abdalla2427/leitura-tc/Documentação/RelatorioParcial/imagens/esquema_ambiente_de_testes_2.jpeg

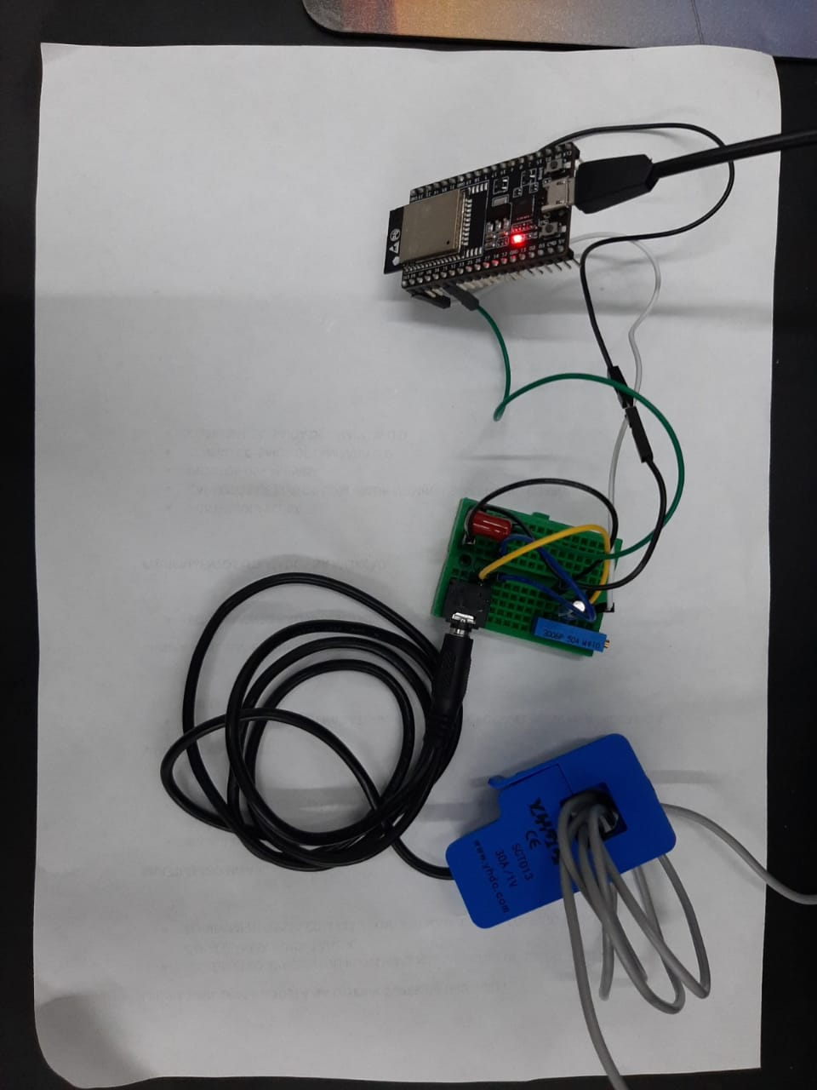
Documentação/RelatorioParcial/imagens/esquema_ambiente_de_testes_2.jpeg
