abdalla2427/leitura-tc/Documentação/RelatorioParcial/imagens/CasoBase_adc_data.pdf

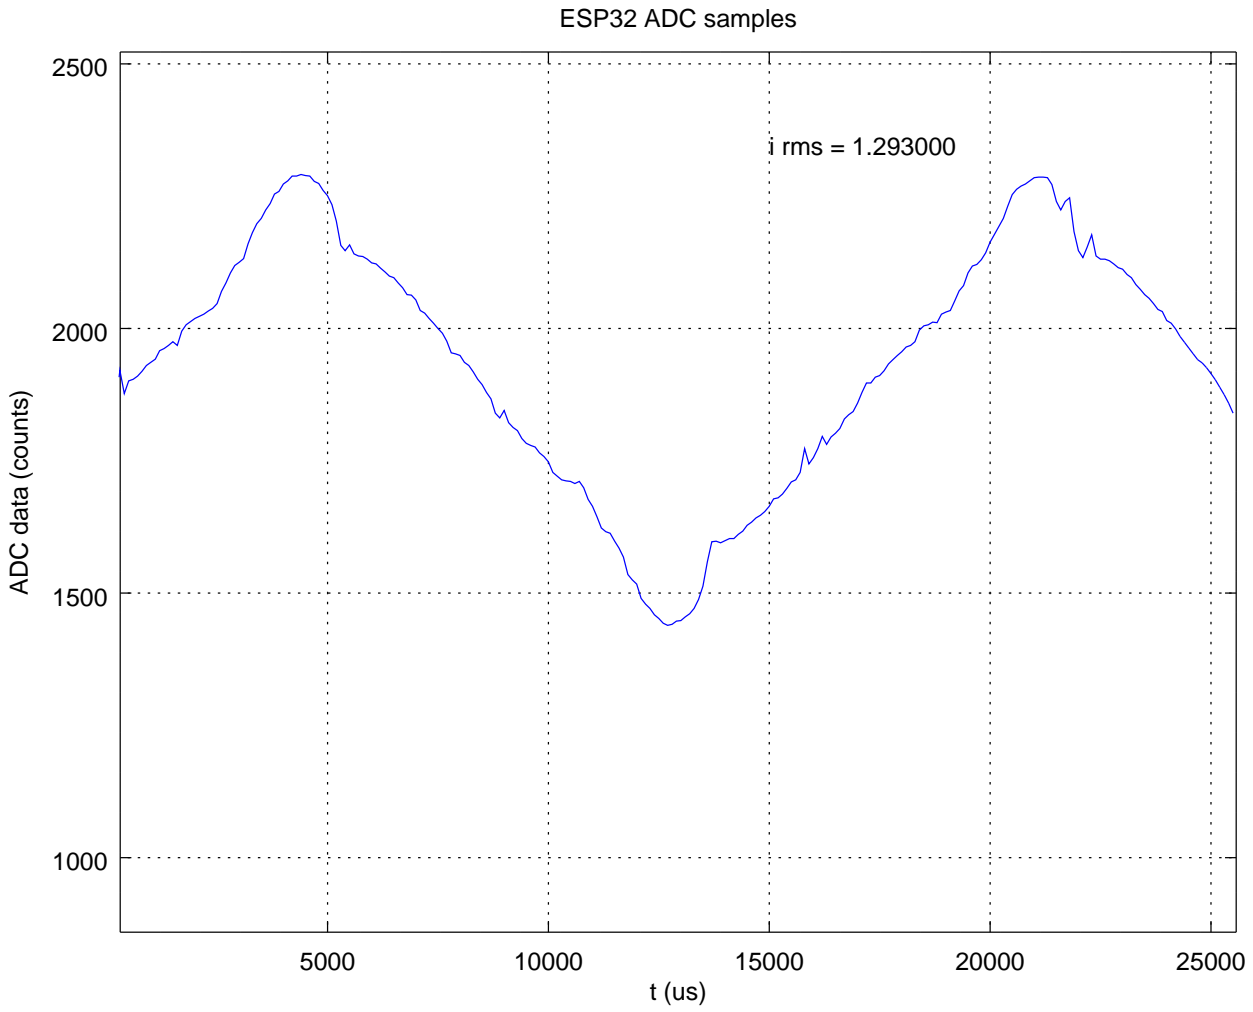
[picture p63: figure]
ESP32 ADC samples; ADC data (counts); i rms = 1.293000
