abdalla2427/leitura-tc/Documentação/Relatório Final/Arquivos úteis/registro_de_eventos_07_06_2020.csv

Tipo de aparelho | Tipo de evento | Hora do evento (HH:MM)
1 | 1 | 12:12
2 | 1 | 12:22
 | 0 | 12:34
1 | 0 | 12:50
