abdalla2427/leitura-tc/Documentação/EasyEDACircuitos/esquema_ambiente/Schematic_diagrama-tc_Sheet_1_20200322113059.png

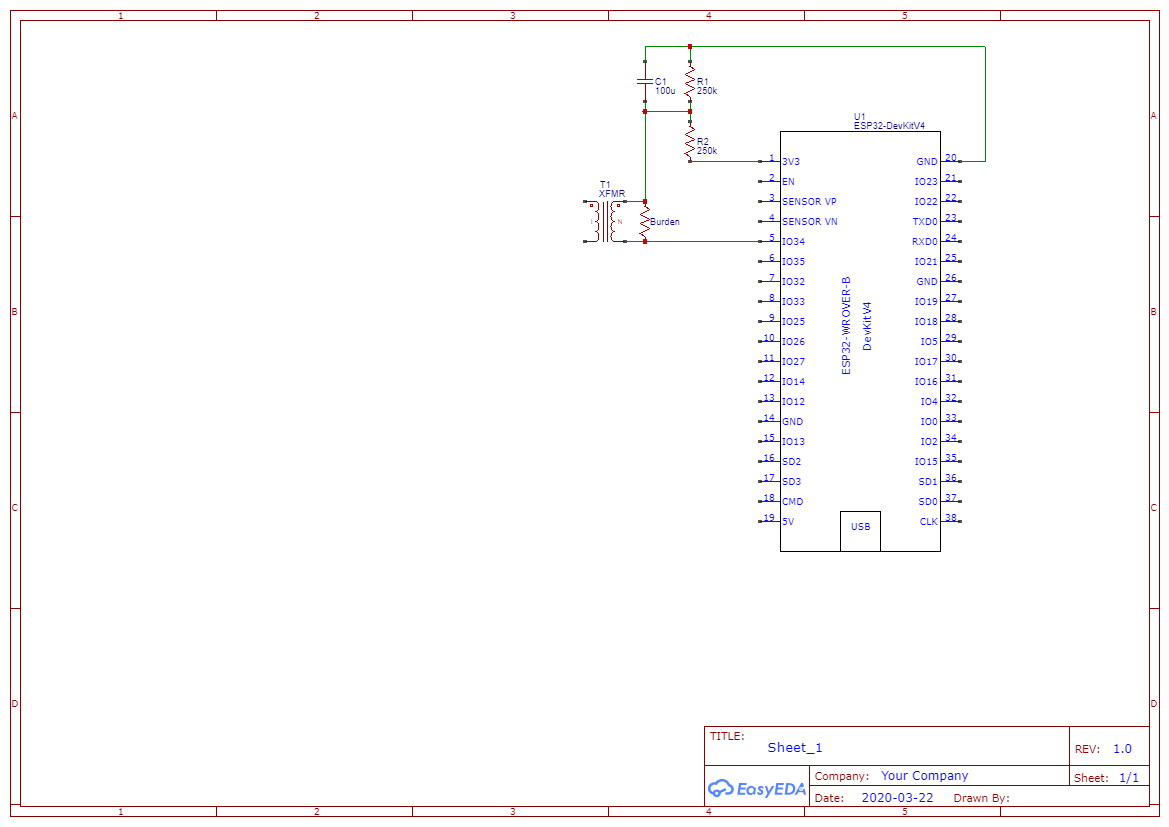
Documentação/EasyEDACircuitos/esquema_ambiente/Schematic_diagrama-tc_Sheet_1_20200322113059.png
