abdalla2427/leitura-tc/Documentação/RelatorioParcial/imagens/circuito_e_tc2.jpg

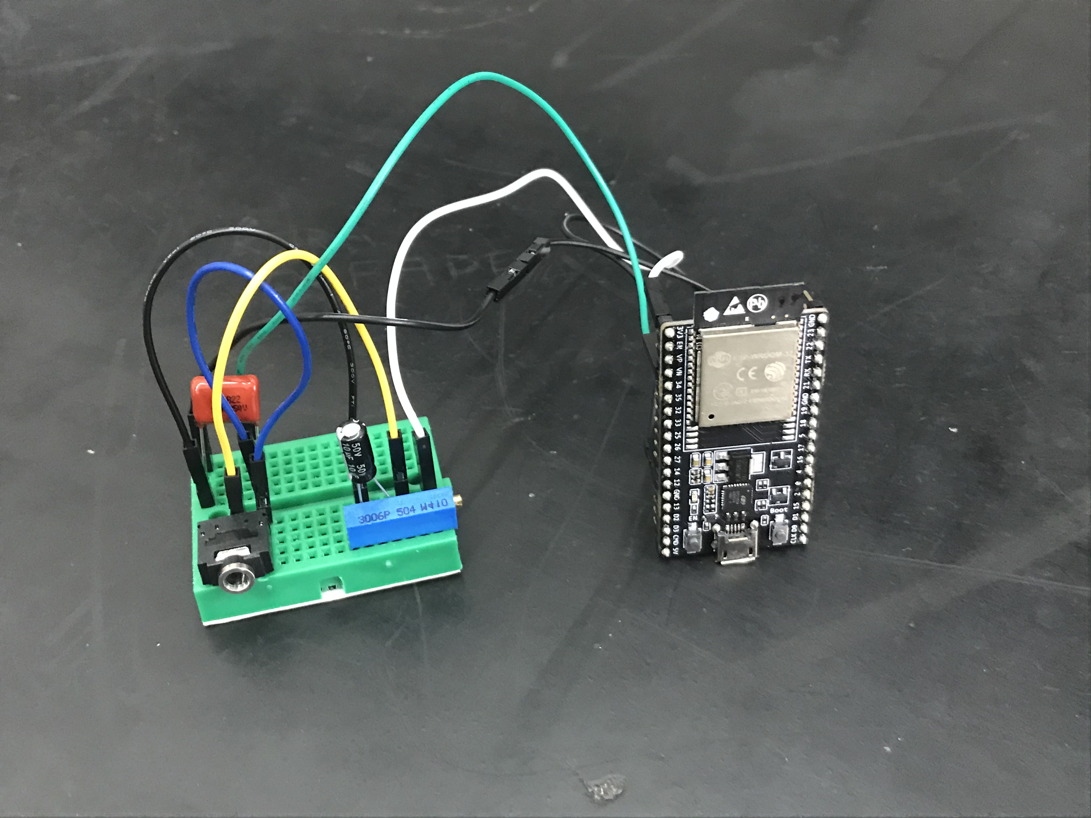
Documentação/RelatorioParcial/imagens/circuito_e_tc2.jpg
