abdalla2427/leitura-tc/Documentação/RelatorioParcial/imagens/circuito_e_tc3.jpg

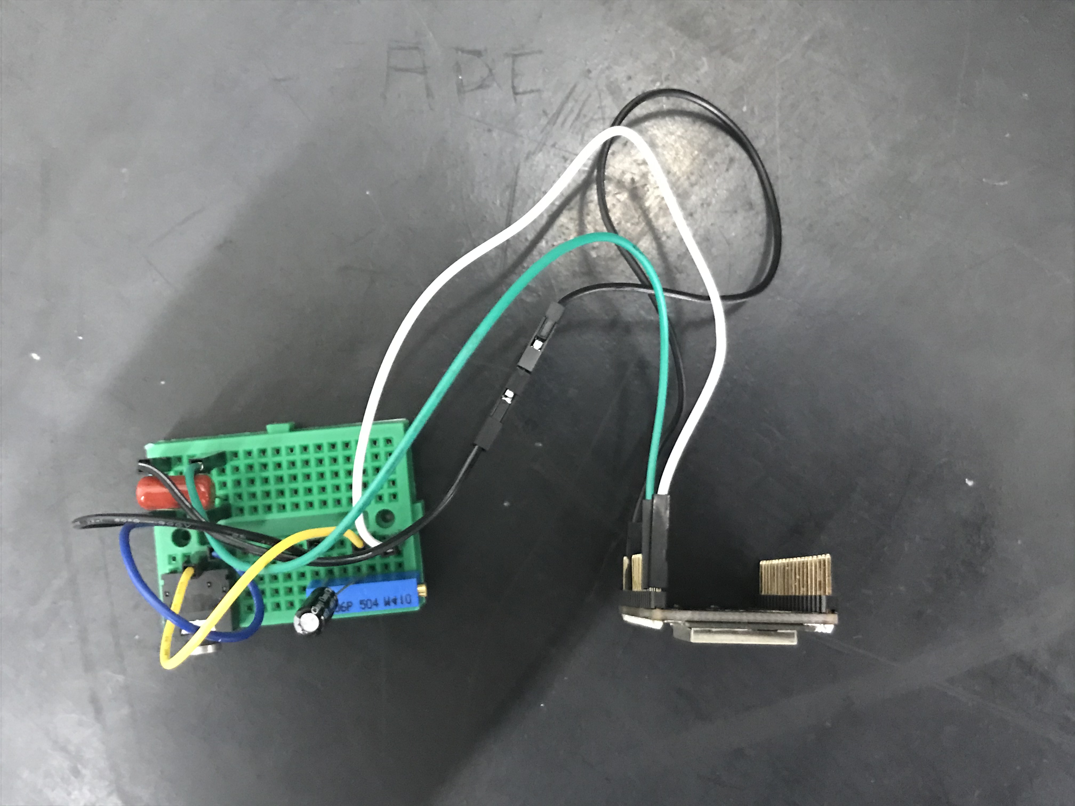
Documentação/RelatorioParcial/imagens/circuito_e_tc3.jpg
