abdalla2427/leitura-tc/Documentação/RelatorioParcial/imagens/circuito_e_tc.jpg

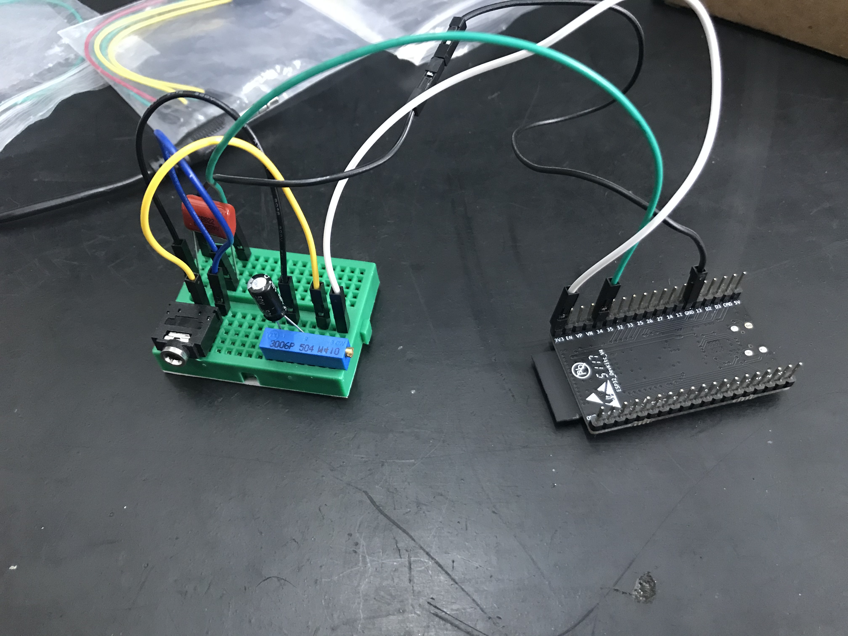
Documentação/RelatorioParcial/imagens/circuito_e_tc.jpg
