abdalla2427/leitura-tc/Documentação/RelatorioParcial/imagens/desenho projeto.png

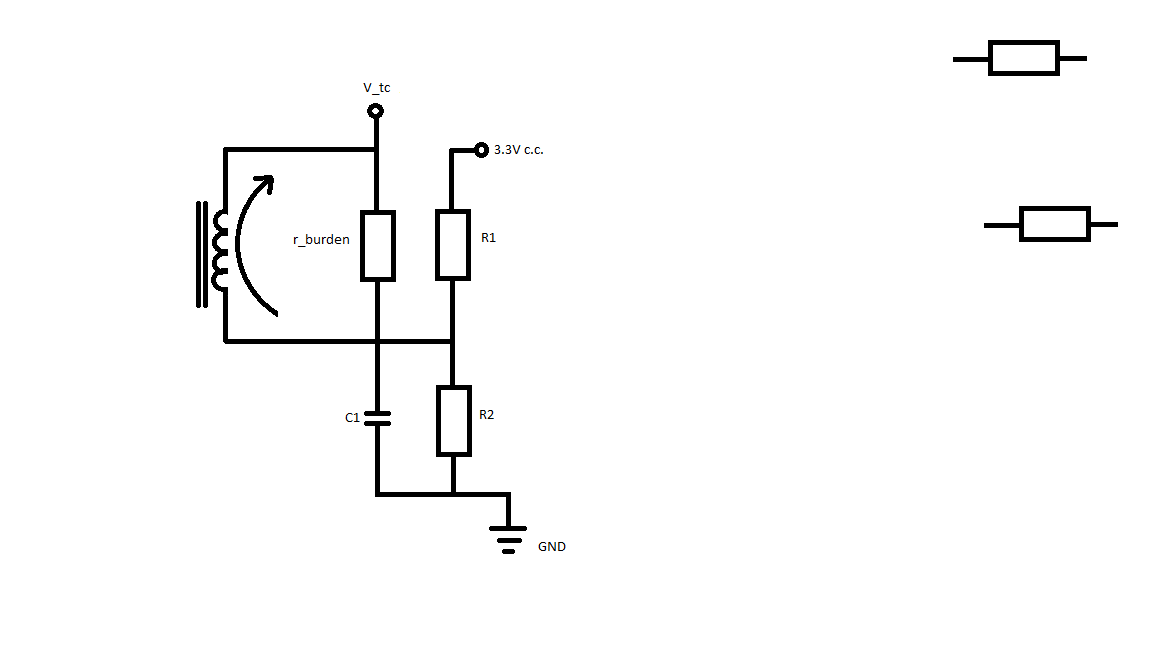
Documentação/RelatorioParcial/imagens/desenho projeto.png
