abdalla2427/leitura-tc/Documentação/RelatorioParcial/imagens/desenho projeto_com_tc.png

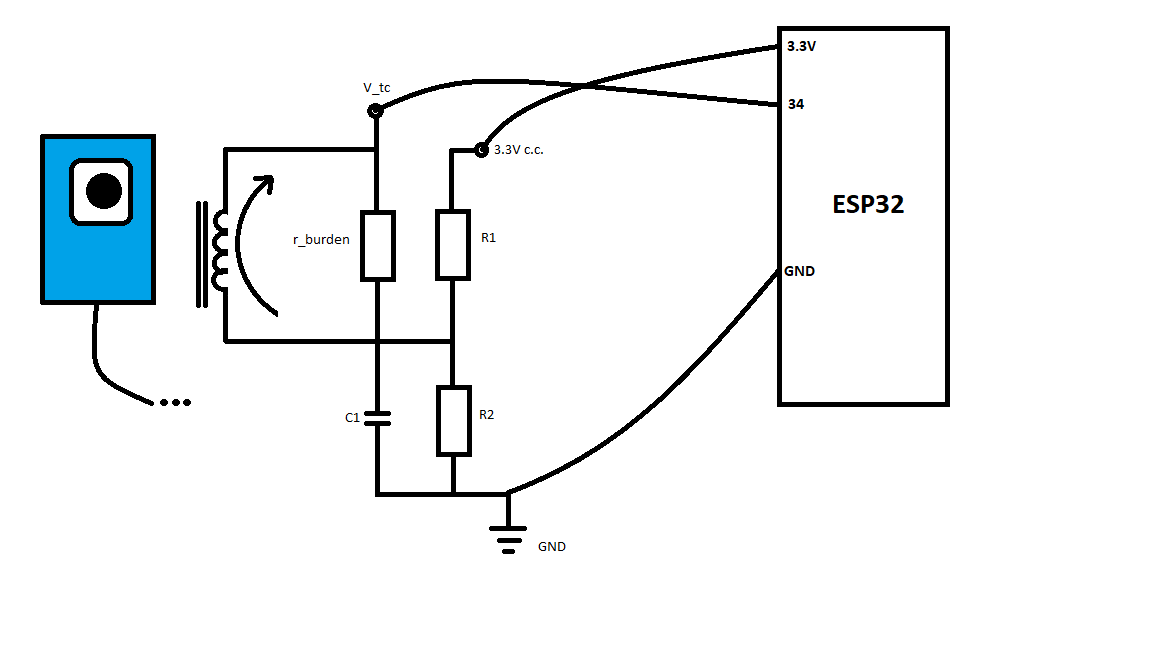
Documentação/RelatorioParcial/imagens/desenho projeto_com_tc.png
