abdalla2427/leitura-tc/Documentação/RelatorioParcial/imagens/esquema_interrupcao.png

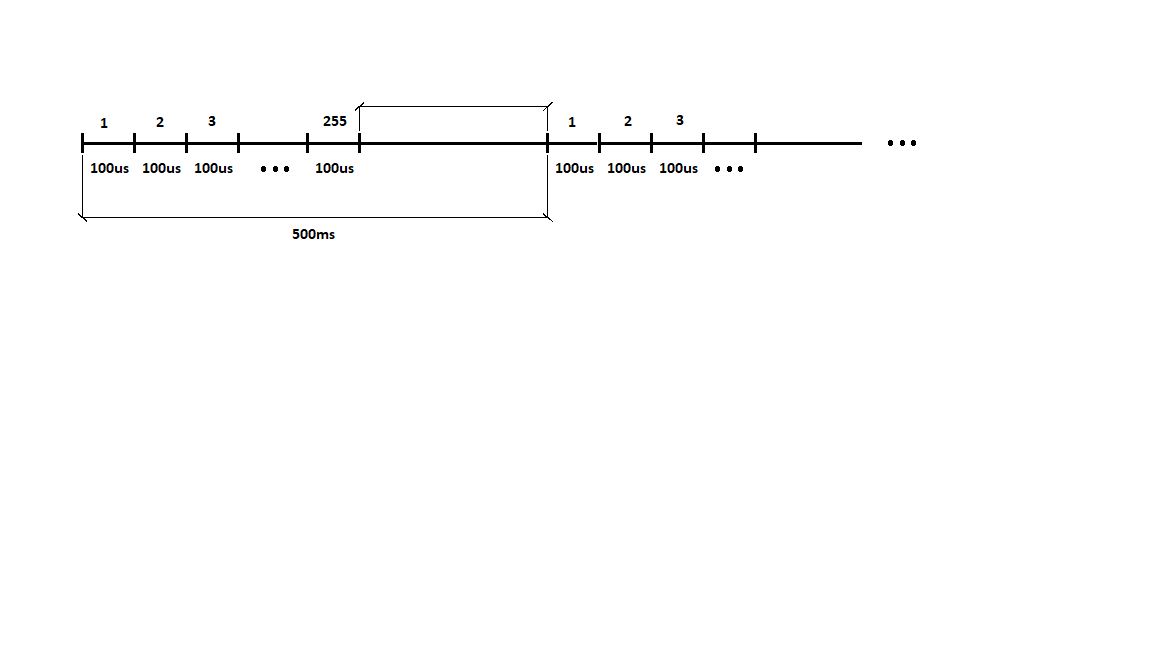
Documentação/RelatorioParcial/imagens/esquema_interrupcao.png
