abdalla2427/leitura-tc/Documentação/RelatorioParcial/imagens/WhatsApp Image 2020-02-19 at 18.54.48.jpeg

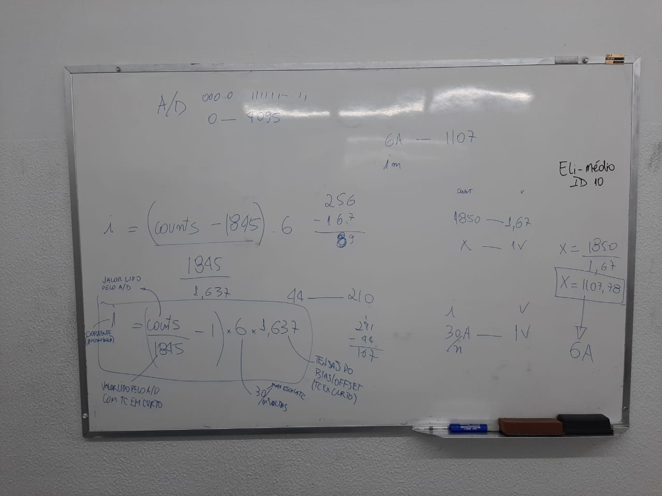
Documentação/RelatorioParcial/imagens/WhatsApp Image 2020-02-19 at 18.54.48.jpeg
