abdalla2427/leitura-tc/Documentação/print_osciloscopio_17fev2020/F0001CH1.CSV

Record Length | 2.500000e+03 | -0.050000000000 | 1.96000
Sample Interval | 4.000000e-05 | -0.049960000000 | 2.00000
Trigger Point | 1.250000000000e+03 | -0.049920000000 | 2.00000
 |  | -0.049880000000 | 2.00000
 |  | -0.049840000000 | 2.08000
 |  | -0.049800000000 | 2.08000
Source | CH1 | -0.049760000000 | 2.08000
Vertical Units | V | -0.049720000000 | 2.12000
Vertical Scale | 1.000000e+00 | -0.049680000000 | 2.08000
Vertical Offset | 0.000000e+00 | -0.049640000000 | 2.12000
Horizontal Units | s | -0.049600000000 | 2.12000
Horizontal Scale | 1.000000e-02 | -0.049560000000 | 2.08000
Pt Fmt | Y | -0.049520000000 | 2.08000
Yzero | 0.000000e+00 | -0.049480000000 | 2.08000
Probe Atten | 1.000000e+01 | -0.049440000000 | 2.08000
Model Number | TBS1052B | -0.049400000000 | 2.08000
Serial Number | C041187 | -0.049360000000 | 2.04000
Firmware Version | FV:v4.06 | -0.049320000000 | 2.04000
 |  | -00.049280000000 | 2.04000
 |  | -00.049240000000 | 2.00000
 |  | -00.049200000000 | 2.00000
 |  | -00.049160000000 | 2.00000
 |  | -00.049120000000 | 1.96000
 |  | -00.049080000000 | 1.96000
 |  | -00.049040000000 | 1.92000
 |  | -00.049000000000 | 1.88000
 |  | -00.048960000000 | 1.92000
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
