abdalla2427/leitura-tc/Documentação/print_osciloscopio_17fev2020/F0001TEK.BMP

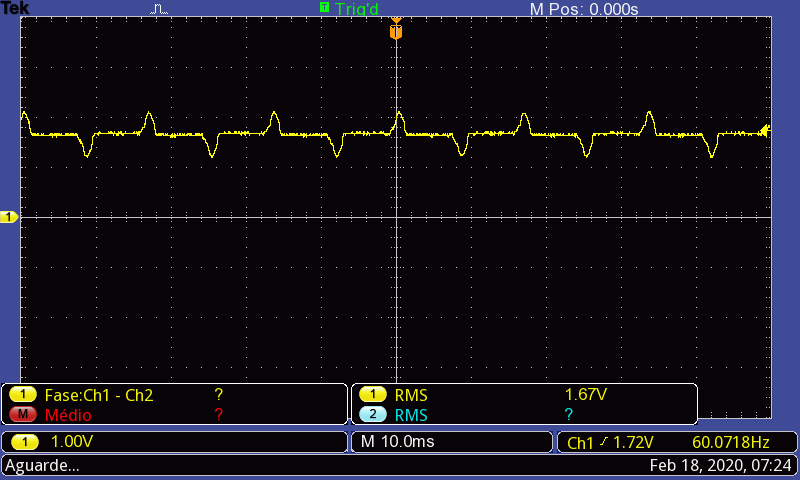
Documentação/print_osciloscopio_17fev2020/F0001TEK.BMP
