abdalla2427/leitura-tc/Banco Para Treinamento/Teste/versao4/teste_classificador.csv

1a amostra | 2a amostra | 3a amostra | 4a amostra | 5a amostra | ClasseAparelho
0.746 | 0.740 | 0.735 | 0.805 | 1.346 | 1
0.740 | 0.735 | 0.805 | 1.346 | 1.339 | 1
0.735 | 0.805 | 1.346 | 1.339 | 1.330 | 1
0.805 | 1.346 | 1.339 | 1.330 | 1.361 | 1
1.346 | 1.339 | 1.330 | 1.361 | 1.733 | 1
1.339 | 1.330 | 1.361 | 1.733 | 2.877 | 1
1.330 | 1.361 | 1.733 | 2.877 | 2.879 | 1
1.361 | 1.733 | 2.877 | 2.879 | 2.879 | 1
1.733 | 2.877 | 2.879 | 2.879 | 2.877 | 1
0.746 | 0.744 | 0.748 | 0.736 | 1.332 | 1
0.744 | 0.748 | 0.736 | 1.332 | 1.317 | 1
0.748 | 0.736 | 1.332 | 1.317 | 1.315 | 1
0.736 | 1.332 | 1.317 | 1.315 | 1.381 | 1
1.332 | 1.317 | 1.315 | 1.381 | 1.929 | 1
1.317 | 1.315 | 1.381 | 1.929 | 2.872 | 1
1.315 | 1.381 | 1.929 | 2.872 | 2.877 | 1
1.381 | 1.929 | 2.872 | 2.877 | 2.892 | 1
1.929 | 2.872 | 2.877 | 2.892 | 2.876 | 1
0.750 | 0.748 | 0.761 | 0.724 | 1.668 | 1
0.748 | 0.761 | 0.724 | 1.668 | 1.618 | 1
0.761 | 0.724 | 1.668 | 1.618 | 1.658 | 1
0.724 | 1.668 | 1.618 | 1.658 | 2.067 | 1
1.668 | 1.618 | 1.658 | 2.067 | 2.845 | 1
1.618 | 1.658 | 2.067 | 2.845 | 2.837 | 1
1.658 | 2.067 | 2.845 | 2.837 | 2.844 | 1
2.067 | 2.845 | 2.837 | 2.844 | 2.820 | 1
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
