abdalla2427/leitura-tc/Banco Para Treinamento/Teste/versao1/teste_classificador.csv

1a amostra | 2a amostra | 3a amostra | 4a amostra | 5a amostra | ClasseAparelho
0.799 | 1.541 | 1.522 | 1.522 | 1.555 | 1
1.541 | 1.522 | 1.522 | 1.555 | 1.761 | 1
1.522 | 1.522 | 1.555 | 1.761 | 2.800 | 1
1.522 | 1.555 | 1.761 | 2.800 | 2.808 | 1
1.555 | 1.761 | 2.800 | 2.808 | 2.813 | 1
1.761 | 2.800 | 2.808 | 2.813 | 2.821 | 1
2.911 | 2.921 | 2.929 | 2.818 | 0.704 | 2
2.921 | 2.929 | 2.818 | 0.704 | 0.707 | 2
2.929 | 2.818 | 0.704 | 0.707 | 0.719 | 2
2.818 | 0.704 | 0.707 | 0.719 | 0.700 | 2
0.764 | 0.775 | 0.764 | 0.759 | 0.767 | 0
0.775 | 0.764 | 0.759 | 0.767 | 0.761 | 0
0.764 | 0.759 | 0.767 | 0.761 | 0.758 | 0
0.759 | 0.767 | 0.761 | 0.758 | 0.763 | 0
0.767 | 0.761 | 0.758 | 0.763 | 0.768 | 0
0.761 | 0.758 | 0.763 | 0.768 | 0.761 | 0
0.758 | 0.763 | 0.768 | 0.761 | 0.753 | 0
0.763 | 0.768 | 0.761 | 0.753 | 0.553 | 0
0.768 | 0.761 | 0.753 | 0.553 | 0.554 | 0
0.761 | 0.753 | 0.553 | 0.554 | 0.553 | 0
0.753 | 0.553 | 0.554 | 0.553 | 0.560 | 0
0.553 | 0.554 | 0.553 | 0.560 | 0.548 | 0
0.554 | 0.553 | 0.560 | 0.548 | 0.551 | 0
0.553 | 0.560 | 0.548 | 0.551 | 0.545 | 0
0.560 | 0.548 | 0.551 | 0.545 | 0.555 | 0
0.548 | 0.551 | 0.545 | 0.555 | 0.555 | 0
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
