abdalla2427/leitura-tc/Documentação/AlgoritmoReconhecimentoDeCarga/Formatar Csv para entrada na rede/para_testes.csv

1a amostra | 2a amostra | 3a amostra | 4a amostra | 5a amostra | ClasseAparelho
2.874 | 2.863 | 2.873 | 2.867 | 0.742 | 2
2.863 | 2.873 | 2.867 | 0.742 | 0.736 | 2
2.873 | 2.867 | 0.742 | 0.736 | 0.738 | 2
2.867 | 0.742 | 0.736 | 0.738 | 0.740 | 2
0.742 | 0.736 | 0.738 | 0.740 | 0.739 | 2
0.746 | 0.740 | 0.735 | 0.805 | 1.346 | 1
0.740 | 0.735 | 0.805 | 1.346 | 1.339 | 1
0.735 | 0.805 | 1.346 | 1.339 | 1.330 | 1
0.805 | 1.346 | 1.339 | 1.330 | 1.361 | 1
1.346 | 1.339 | 1.330 | 1.361 | 1.733 | 1
1.339 | 1.330 | 1.361 | 1.733 | 2.877 | 1
1.330 | 1.361 | 1.733 | 2.877 | 2.879 | 1
1.361 | 1.733 | 2.877 | 2.879 | 2.879 | 1
1.733 | 2.877 | 2.879 | 2.879 | 2.877 | 1
2.877 | 2.879 | 2.879 | 2.877 | 2.849 | 1
2.867 | 2.864 | 2.868 | 2.862 | 0.740 | 2
2.864 | 2.868 | 2.862 | 0.740 | 0.743 | 2
2.868 | 2.862 | 0.740 | 0.743 | 0.742 | 2
2.862 | 0.740 | 0.743 | 0.742 | 0.743 | 2
0.740 | 0.743 | 0.742 | 0.743 | 0.734 | 2
0.746 | 0.744 | 0.748 | 0.736 | 1.332 | 1
0.744 | 0.748 | 0.736 | 1.332 | 1.317 | 1
0.748 | 0.736 | 1.332 | 1.317 | 1.315 | 1
0.736 | 1.332 | 1.317 | 1.315 | 1.381 | 1
1.332 | 1.317 | 1.315 | 1.381 | 1.929 | 1
1.317 | 1.315 | 1.381 | 1.929 | 2.872 | 1
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
