abdalla2427/leitura-tc/Documentação/AlgoritmoReconhecimentoDeCarga/Formatar Csv para entrada na rede/para_testes/nada.csv

ValoresRms | TimeStamp | EPOCH | ClasseAparelho
0.446 | 15/07/2020 05:11:34.190 | 1594800694190 | 0
0.445 | 15/07/2020 05:11:34.690 | 1594800694690 | 0
0.450 | 15/07/2020 05:11:35.190 | 1594800695190 | 0
0.446 | 15/07/2020 05:11:35.690 | 1594800695690 | 0
0.444 | 15/07/2020 05:11:36.190 | 1594800696190 | 0
0.445 | 15/07/2020 05:11:36.690 | 1594800696690 | 0
0.431 | 15/07/2020 05:11:37.190 | 1594800697190 | 0
0.445 | 15/07/2020 05:11:37.690 | 1594800697690 | 0
0.444 | 15/07/2020 05:11:38.190 | 1594800698190 | 0
0.443 | 15/07/2020 05:11:38.690 | 1594800698690 | 0
0.442 | 15/07/2020 05:11:39.190 | 1594800699190 | 0
0.443 | 15/07/2020 05:11:39.690 | 1594800699690 | 0
0.440 | 15/07/2020 05:11:40.190 | 1594800700190 | 0
0.446 | 15/07/2020 05:11:40.691 | 1594800700691 | 0
0.441 | 15/07/2020 05:11:41.191 | 1594800701191 | 0
0.453 | 15/07/2020 05:11:41.691 | 1594800701691 | 0
0.443 | 15/07/2020 05:11:42.191 | 1594800702191 | 0
0.441 | 15/07/2020 05:11:42.691 | 1594800702691 | 0
0.445 | 15/07/2020 05:11:43.191 | 1594800703191 | 0
0.441 | 15/07/2020 05:11:43.691 | 1594800703691 | 0
0.441 | 15/07/2020 05:11:44.191 | 1594800704191 | 0
0.446 | 15/07/2020 05:11:44.691 | 1594800704691 | 0
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
