abdalla2427/leitura-tc/Documentação/RelatorioParcial/imagens/esquema_ambiente_de_testes_3.jpeg

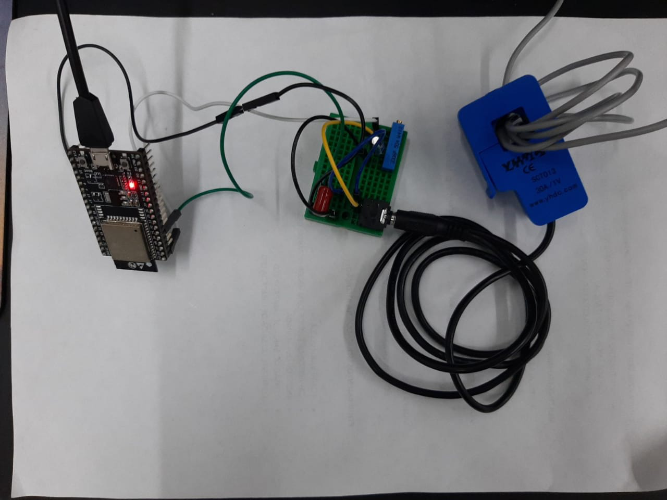
Documentação/RelatorioParcial/imagens/esquema_ambiente_de_testes_3.jpeg
