abdalla2427/leitura-tc/Documentação/RelatorioParcial/imagens/esquema_quadro_ambiente_de_testes.jpg

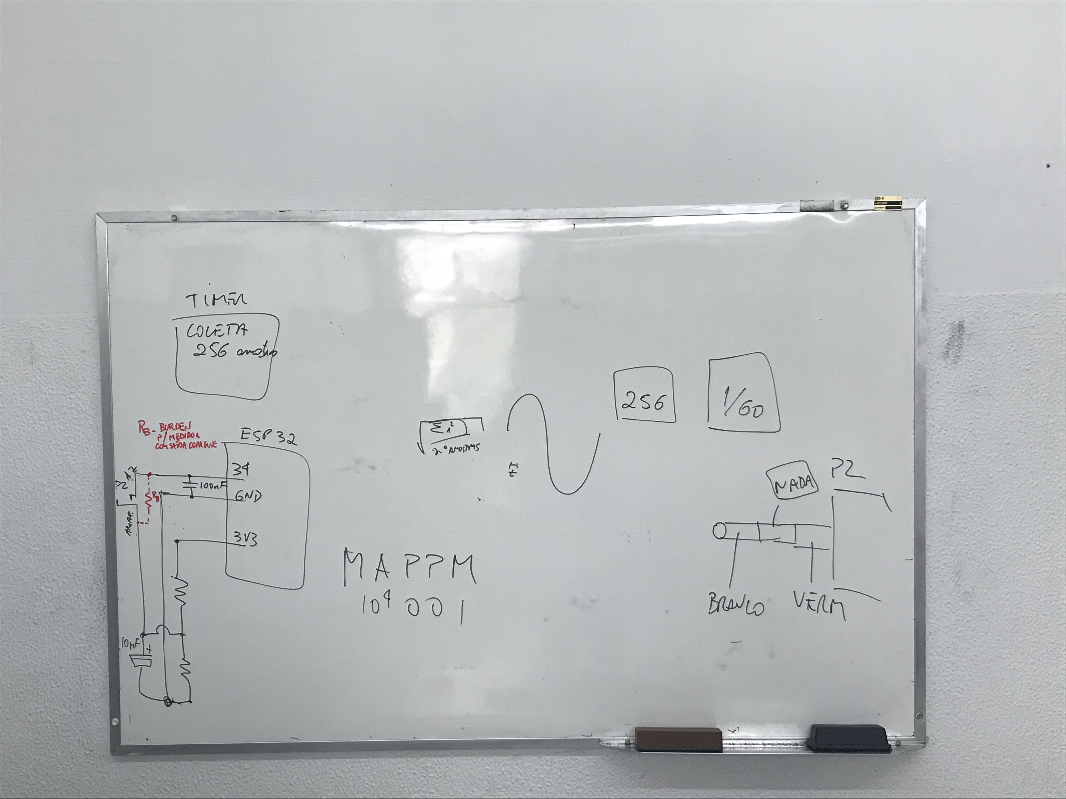
Documentação/RelatorioParcial/imagens/esquema_quadro_ambiente_de_testes.jpg
