abdalla2427/leitura-tc/Documentação/RelatorioParcial/imagens/CasoBase_i_rms.pdf

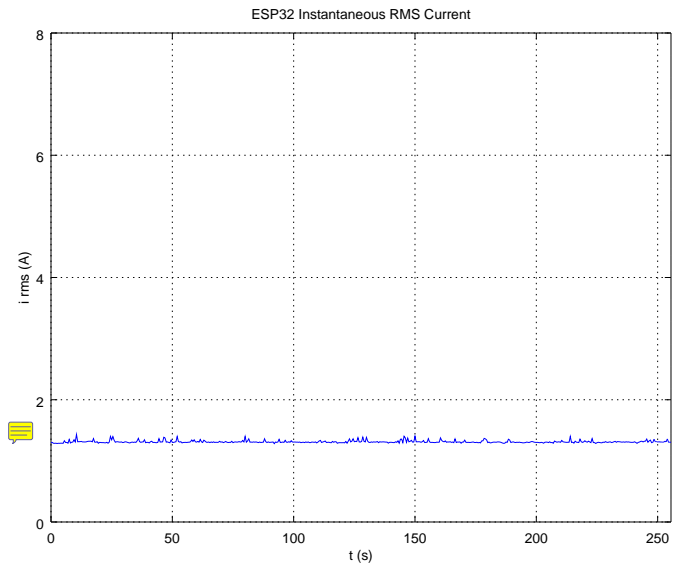
[picture p79: page 1]
i rms (A)

ESP32 Instantaneous RMS Current
