abdalla2427/leitura-tc/Documentação/RelatorioParcial/imagens/MicroondaseMáquinadeLavar_i_rms_Parte1.pdf

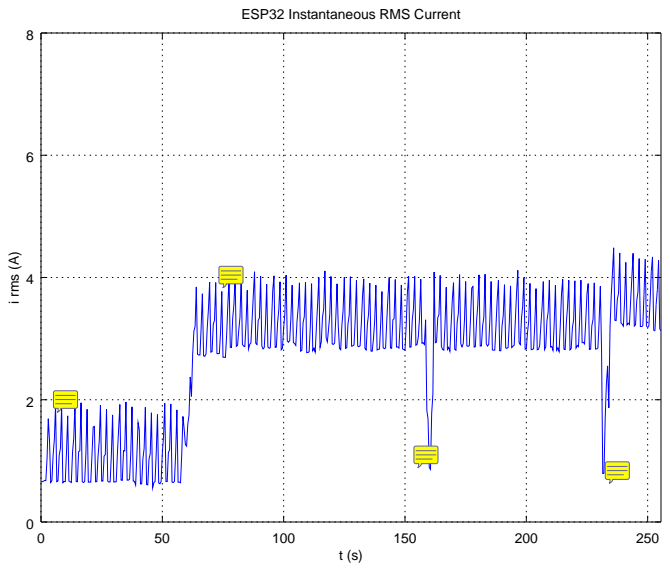
[picture p80: page 1]
i rms (A)

ESP32 Instantaneous RMS Current
