abdalla2427/leitura-tc/(commit log)

2020-02-18 fotos osciloscopio
    [F0001CH1.CSV]
2020-03-23 Relatorio atualizado 23 de março
2020-04-18 Diretorio especifico para o apk
2020-05-02 correcoes feitas
    [rms02052020151750279.csv]
2020-05-05 correcao tempo
    [rms05052020204257054.csv, rms05052020204317575.csv]
2020-05-10 correcoes feitas apos diagrama
    [rms10_05_2020____15_38_42_342.csv]
2020-05-12 salva csv ao resetar
    [rms10_05_2020____19_12_53_215.csv, rms12_05_2020____17_40_38_466.csv]
2020-05-12 exporrta csv em caso de timeout
    [rms12_05_2020____17_40_38_466.csv, rms12_05_2020____18_14_45_477.csv, rms12_05_2020____18_28_17_395.csv]
2020-05-12 correcao dee TUDO
    [rms12_05_2020____18_14_45_477.csv, rms12_05_2020____18_28_17_395.csv]
2020-05-12 ultimos csvs
    [rms12_05_2020____19_07_31_903.csv, rms12_05_2020____19_07_47_667.csv, rms12_05_2020____19_14_00_649.csv, rms12_05_2020____19_27_16_249.csv, rms12_05_2020____19_32_38_322.csv, rms12_05_2020____19_33_05_974.csv, rms12_05_2020____19_36_58_737.csv, rms12_05_2020____19_39_53_809.csv]
2020-05-22 correcao codigo
    [rms22_05_2020____17_28_20_998.csv, rms22_05_2020____17_30_14_009.csv, rms22_05_2020____17_44_00_932.csv, rms22_05_2020____17_49_09_466.csv]
2020-05-22 mudanca de pastas
2020-05-23 mudanca no server
    [rms22_05_2020____17_28_20_998.csv, rms22_05_2020____17_30_14_009.csv, rms22_05_2020____17_44_00_932.csv, rms22_05_2020____17_49_09_466.csv, rms22_05_2020____20_08_44_493.csv, rms22_05_2020____20_49_16_606.csv, rms22_05_2020____21_04_12_299.csv, rms22_05_2020____21_21_54_833.csv]
2020-05-23 mudancas no html, mostrando ip, tempo de captura, e graficos
    [rms23_05_2020____09_53_34_236.csv, rms23_05_2020____09_58_36_883.csv, rms23_05_2020____10_09_16_965.csv, rms23_05_2020____10_19_56_981.csv, rms23_05_2020____10_30_37_081.csv, rms23_05_2020____10_41_17_068.csv]
2020-05-23 novos csvs
    [rms23_05_2020____09_16_29_911.csv, rms23_05_2020____09_18_05_038.csv, rms23_05_2020____09_43_40_822.csv, rms23_05_2020____09_58_36_629.csv, rms23_05_2020____09_59_03_312.csv, rms23_05_2020____10_22_09_424.csv, rms23_05_2020____10_24_12_844.csv, rms23_05_2020____10_39_08_640.csv]
2020-06-02 csvs gerados
    [rms01_06_2020____03_15_34_182.csv, rms01_06_2020____19_53_24_754.csv, rms01_06_2020____23_24_58_642.csv, rms02_06_2020____17_43_32_244.csv, rms23_05_2020____12_22_06_480.csv, rms23_05_2020____12_30_04_781.csv, rms23_05_2020____12_47_09_082.csv, rms23_05_2020____12_52_45_967.csv]
2020-06-04 script para calculo
2020-06-04 mudanca pasta rms
    [rms01_06_2020____03_15_34_182.csv, rms01_06_2020____19_53_24_754.csv, rms01_06_2020____23_24_58_642.csv, rms02_06_2020____17_43_32_244.csv, rms04_06_2020____01_43_21_917.csv, rms22_05_2020____20_08_44_493.csv, rms22_05_2020____20_49_16_606.csv, rms22_05_2020____21_04_12_299.csv]
2020-06-06 configuracao a partir de um json, e criacao de uma classe para logger
2020-06-07 nova pasta para versao atualizada
2020-06-07 nova secao de relatorio final
2020-06-07 novos arquivos e modificacao casos de teste
    [registro_de_eventos_07_06_2020.csv]
2020-06-19 codigo dia 28 de maio
2020-06-21 mudanca de todos callbacks de string para char
2020-06-25 criacao codigo stm32
2020-06-28 painel com lista de arquivos rms
2020-06-28 pointeiro fora do range corrigidol
    [ESP32AnalogReadTimerwifi_26jun2020b.ino]
2020-07-01 painel csv
    [rms04_06_2020____01_43_21_917.csv]
2020-07-03 inicio testes merge_csv
    [registro_de_eventos_07_06_2020.csv, rms01_07_2020____17_38_58_837.csv]
2020-07-03 mostra estado atual da captura e so permite que o usuario execute a ação oposta à que está em andamento
2020-07-03 correcao log de timeout
2020-07-05 mudanca para 4 classes no classificador estado ligando e desligandoo para 2 aparelhos
    [merged.csv, registro_de_eventos_01_07_2020.csv, rms01_07_2020____17_38_58_837.csv]
2020-07-06 Mudanças na forma de criação do csv.
2020-07-06 Criação do algoritmo para identificação da carga ligada.
    [merged.csv, registro_de_eventos_01_07_2020.csv, rms01_07_2020____17_38_58_837.csv]
2020-07-10 alteracoes algoritmo
    [01jul2020.csv, 02jul2020.csv, 05jul2020.csv, 06jul2020.csv, merged.csv, primeiro_bloco.csv, quarto_bloco.csv, segundo_bloco.csv]
2020-07-11 copia rede para python
    [saida_teste.csv]
2020-07-11 organizzacao pastas
    [01jul2020.csv, 02jul2020.csv, 05jul2020.csv, 06jul2020.csv, merged.csv, primeiro_bloco.csv, quarto_bloco.csv, registro_de_eventos_01_07_2020.csv]
2020-07-15 correcao python
    [07.csv, merged.csv, rms01_07_2020____17_38_58_837.csv, saida_teste.csv]
2020-07-15 novo script para coluna de classes
    [07.csv, registro_de_eventos_01_07_2020.csv]
2020-07-16 correcao para ClasseAparelho
    [07.csv, primeiro_bloco.csv, quarto_bloco.csv, segundo_bloco.csv, terceiro_bloco.csv]
2020-07-19 mais eventos tipo 2 e class tipo nada adicionados ao banco
    [09.csv, 13.csv, 14.csv, entrada_classificador.csv, eventos_2.csv, nada01.csv, nada02.csv, nada03.csv]
2020-07-19 classificador no esp32
2020-07-25 adicao de platôs reconhecimento
    [entrada_classificador.csv, nada_mock01.csv, nada_mock02.csv, nada_mock03.csv, nada_mock04.csv, sem_eventos.csv]
2020-07-31 novo classificador
    [parte1.csv, parte2.csv, parte3.csv, parte4.csv, teste_classificador.csv]
2020-08-06 versao 4 do Classificador para o .ino
2020-08-30 visualizacao eventos
    [data.csv, primeiro_evento.csv, quarto_eventos.csv, quinto_evento.csv, segundo_evento.csv, terceiro_evento.csv]
2021-04-05 mudanca pasta projeto
    [01.csv, 02.csv, 05.csv, 06.csv, 07.csv, 09.csv, 10.csv, 13.csv]
2021-04-22 geracao de txt com coeficientes classificador
    [entrada_classificador.csv]
2021-05-20 mudanca graficos'
    [saida.csv, teste_mic.csv]
2021-05-21 2 graficos
    [data_grafico_1.csv, data_grafico_2.csv, primeiro_evento.csv]
2021-06-10 iniciomudancas codigo para receber novos pesos classificador
2021-07-27 criacao 09 de jun ino
2021-07-27 adicionando ponteiro para topologia e atualizando pesos por post json
2021-08-03 atualização dos pesos sendo feita de forma correta \o//
2021-09-03 de hoje
